Makerfabs/nRF52840-UWB-DW3000/readme.md

# Makerfabs nRF52840 UWB DW3000

**The DW3000 library in this repository was developed by NConcepts, not Makerfabs.  Makerfabs is simply responsible for maintaining the repository.**

## 1.Intruduce

Product Link ：[nRF52840 UWB DW3000](https://www.makerfabs.com/nrf52840-uwb-dw3000.html) 

Wiki Link : [nRF52840 UWB DW3000](https://wiki.makerfabs.com/nRF52840%20DW3000%20UWB.html)

Usage : [one-anchor--one-tag](https://github.com/Makerfabs/nRF52840-UWB-DW3000#31-one-anchor--one-tag)

[multi-anchor--multi-tag](https://github.com/Makerfabs/nRF52840-UWB-DW3000#32-multi-anchor--multi-tag)

## 2.Feature

- Controller: nRF52840, 64 MHz Cortex-M4 with FPU, 1 MB Flash, 256 KB RAM.
- DW3000 UWB module.

## 3. Usage

Download the DW3000 library in [GitHub](https://github.com/Makerfabs/nRF52840-UWB-DW3000/tree/main/Dw3000), and put it to the Arduino library file.

- The default is usually in the "C:\Users\Your username\Documents\Arduino\libraries"



### 3.1 One Anchor + one Tag

- Prepare the module and connect it to the PC with a USB cable.

- Open the Arduino IDE.

- Click **File-->Examples-->DW3000-->Makerfabs_Range_TX**.



- Select the development board “Nordic nRF52840 DK” and the port.

Nordic nRF52840 DK.png

- Upload the sketch to the board.

IMG20260815163745 (1).jpg

- Prepare **another module** and connect it to the PC with a USB cable.

- Click **File-->Examples-->DW3000-->Makerfabs_Range_RX**.



- Select the development board “Nordic nRF52840 DK” and the port.

- Upload the sketch to the board.



### 3.2 Multi Anchor + Multi Tag

This is the example to get the distance value from multi Tag to multi Anchor.

The network uses a designated **Master Anchor** to coordinate synchronization and network scheduling.

``` 
#define MASTER_ANCHOR_ID    0xA0
```

The Master Anchor serves as the reference node for the entire UWB network and is responsible for:

- TDMA timing coordination
- Tag scheduling reference
- Maintaining a common network time base

All Anchors and Tags in the network must be configured with the same `MASTER_ANCHOR_ID`.

**Set the board to Anchor X or Tag X**

- Open the Arduino IDE.

- Click **File-->Examples-->DW3000-->Makerfabs_Multi_Anchor_Multi_Tag_Anchor** to open the Anchor code.



- Click **File-->Examples-->DW3000-->Makerfabs_Multi_Anchor_Multi_Tag_Tag** to open the Tag code.



Modify code to get the Anchor or Tag that you want to define

``` 
// 0xA0~0xA7
#define MASTER_ANCHOR_ID    0xA0
```

``` 
//For example 0, 1, 2..
#define TAG_ID              0
```

Use Type-C USB cable to connect the board and PC, and select the development board "Nordic nRF52840 DK" and the port.

Nordic nRF52840 DK.png

Verify the code and upload.

Repeat to set up multiple Anchor and multiple Tag.

Open the port for any anchor to view the distances from all tags to all anchors.



Results for 8Tag + 8anchor


### 3.3UWB Positioning Python Program
You can use Python for UWB positioning. Double-click to open [uwb_visualizer.exe](https://github.com/Makerfabs/Makerfabs-ESP32-UWB-DW3000/tree/main/example/uwb_visualizer).



Set the coordinates for the four anchors, select the serial port for one of them, and click “Start” to begin monitoring.
