Makerfabs/nRF52840-UWB-DW3000/Hardware/UWB nRF52840 DW3000 V1.1.PDF

# P0.06P⁰.07

# SCL LEDTX

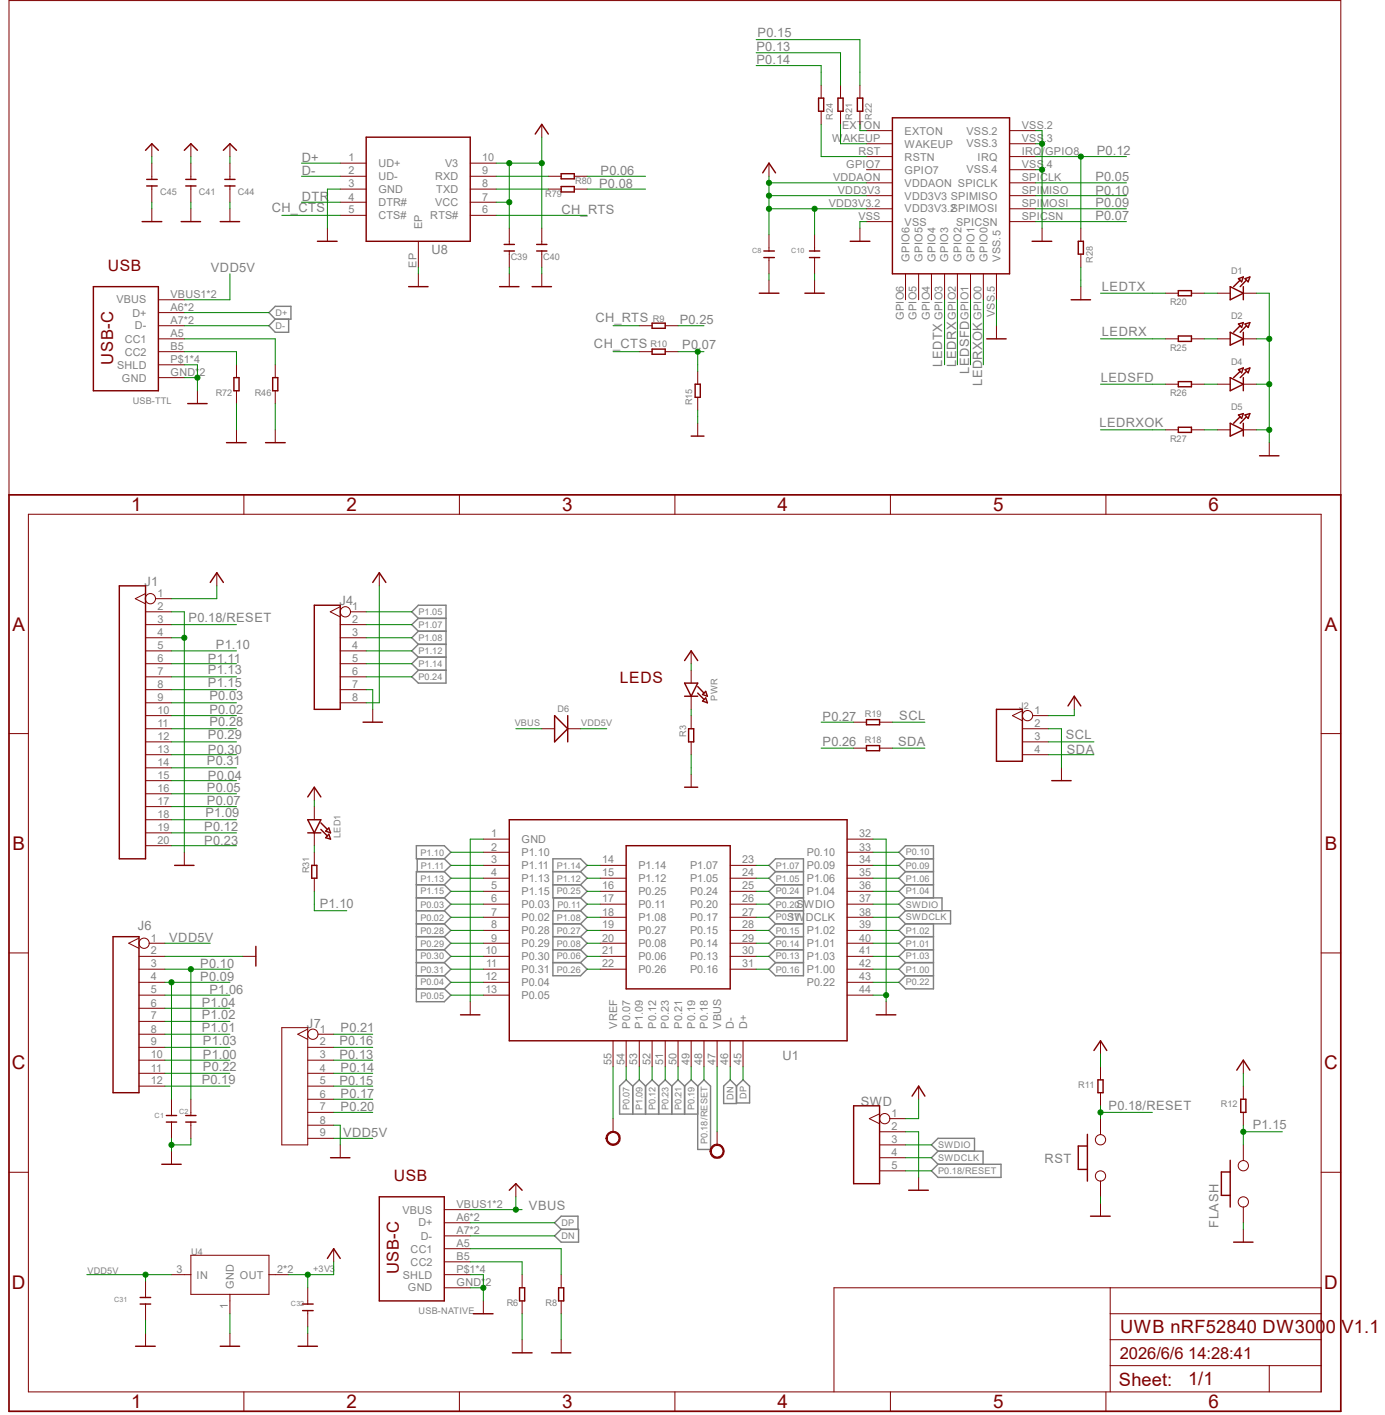
[picture p1: page 1]

6 | P1.04
8 | P1.01
9 | P1.03

4 | SWDCLK
