Makerfabs/nRF52840-UWB-DW3000/Hardware/UWB nRF52840 DW3000 V1.1.brd

## EAGLE design Hardware/UWB nRF52840 DW3000 V1.1.brd (2026-08-15)

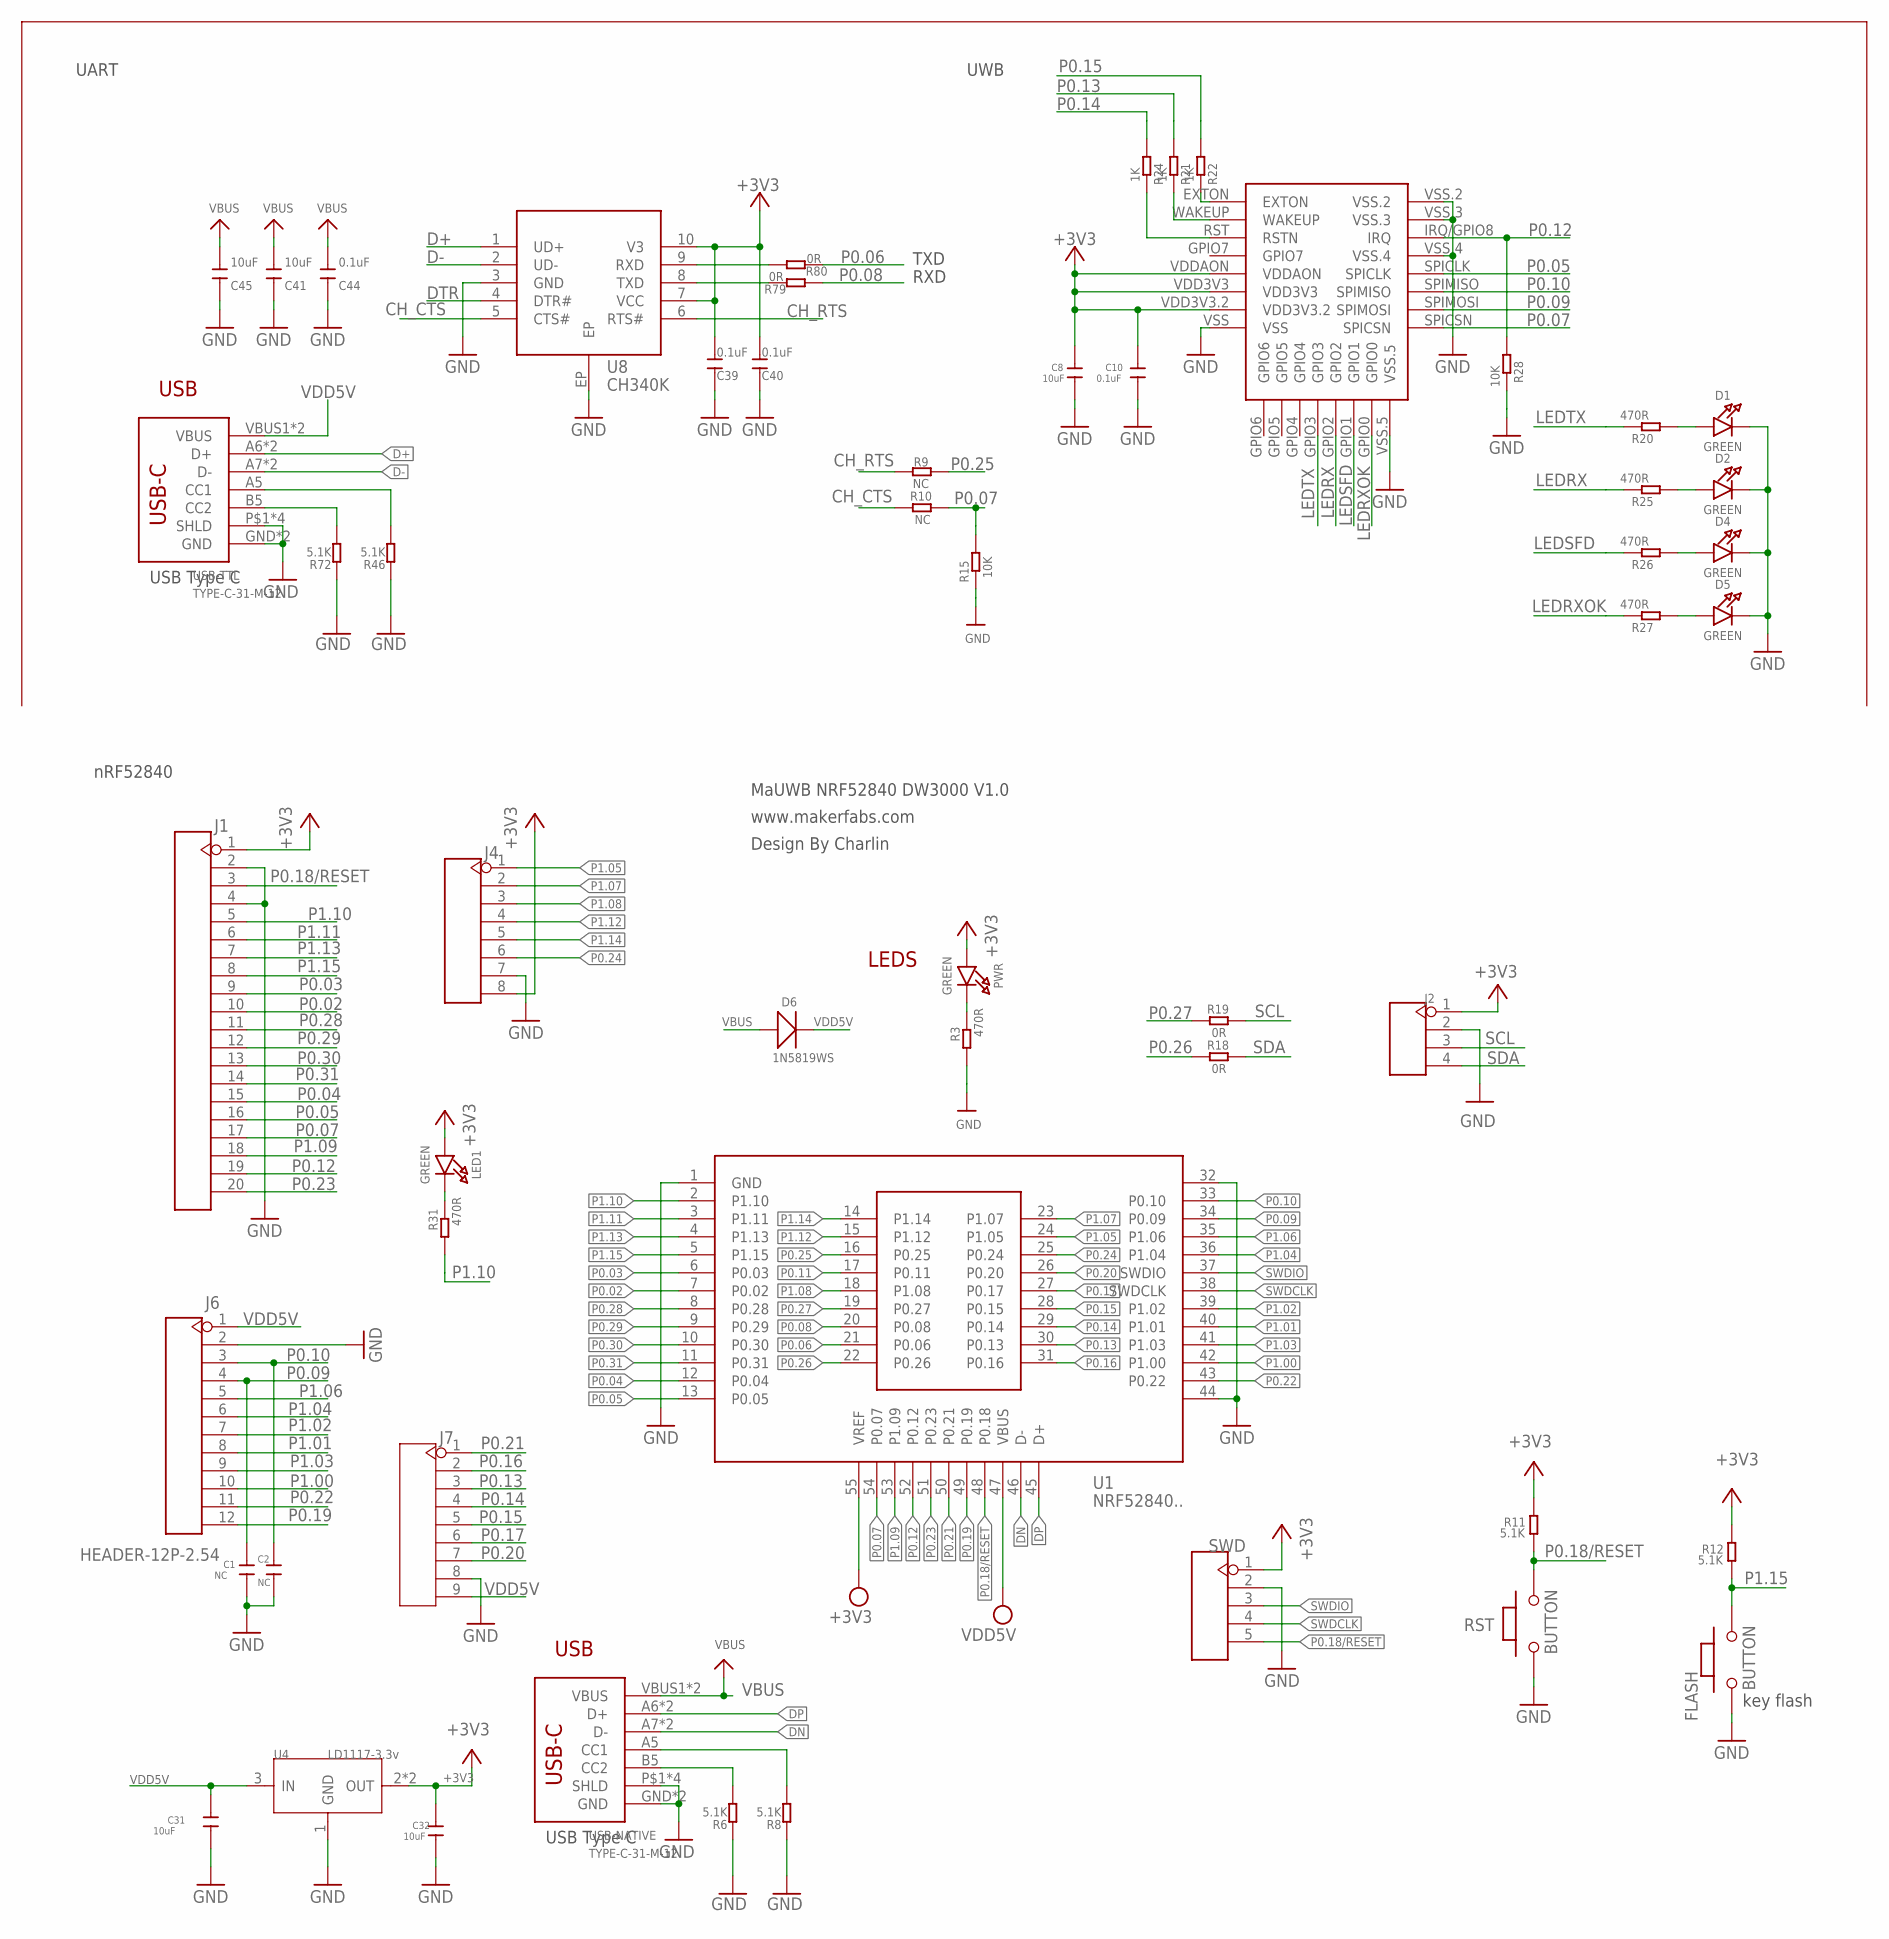
[picture p2: schematic UWB nRF52840 DW3000 V1.1.sch]

Parts:
C1, C2: NC; C0603
C8, C31, C32: 10uF; C0603
C10: 0.1uF; C0603
C39, C40, C44: 0.1uF; DISCRETE_C0603
C41, C45: 10uF; DISCRETE_C0603
D1, D2, D4, D5: GREEN; CHIPLED_0805_NOOUTLINE
D6: 1N5819WS; SOD323
FLASH: BUTTON; 157SW
J1: HEADER-20P-2.54; 20P-2.54
J2: HEADER-4P-60/35MILROUND; 4P-65/35ROUND
J4: HEADER-8P-2.54; 8P-2.54
J6: HEADER-12P-2.54; 12P-2.54
J7: HEADER-9P-2.54; 9P-2.54
LED1: GREEN; CHIPLED_0805_NOOUTLINE
PWR: GREEN; CHIPLED_0805_NOOUTLINE
R3, R20, R25, R26, R27, R31: 470R; R0603
R6, R8, R46, R72: 5.1K; DISCRETE_R0603
R9, R10: NC; R0603
R11, R12: 5.1K; R0603
R15, R28: 10K; R0603
R18, R19, R79, R80: 0R; R0603
R21, R22, R24: 1K; R0603
RST: BUTTON; 157SW
SWD: HEADER-5P-2.54; 5P-2.54
U1: NRF52840..
U4: LD1117-3.3v; SOT89
U5: DWM1000
U8: CH340K; ESOP-10-EP-150MIL
USB-NATIVE: TYPE-C-31-M-12
USB-TTL: TYPE-C-31-M-12

Connections:
+3V3: C8.1, C10.1, C32.1, C39.2, C40.2, J1.1, J2.1, J4.8, LED1.A, PWR.A, R11.2, R12.2, SWD.1, U1.55 (VREF), U4.2 (OUT), U4.4 (OUT), U5.VDD3V3, U5.VDD3V3.2, U5.VDDAON, U8.7 (VCC), U8.10 (V3)
CH_CTS: R10.2, U8.5 (CTS#)
CH_RTS: R9.2, U8.6 (RTS#)
D+: U8.1 (UD+), USB-TTL.A6 (D+), USB-TTL.B6 (D+)
D-: U8.2 (UD-), USB-TTL.A7 (D-), USB-TTL.B7 (D-)
DN: U1.46 (D-), USB-NATIVE.A7 (D-), USB-NATIVE.B7 (D-)
DP: U1.45 (D+), USB-NATIVE.A6 (D+), USB-NATIVE.B6 (D+)
DTR: U8.4 (DTR#)
GND: C1.2, C2.2, C8.2, C10.2, C31.2, C32.2, C39.1, C40.1, C41.1, C44.1, C45.1, D1.C, D2.C, D4.C, D5.C, FLASH.1, J1.2, J1.4, J2.2, J4.7, J6.2, J7.8, R3.2, R6.1, R8.1, R15.2, R28.1, R46.1, R72.1, RST.1, SWD.2, U1.1 (GND), U1.32, U1.44, U4.1 (GND), U5.VSS, U5.VSS.2, U5.VSS.3, U5.VSS.4, U5.VSS.5, U8.3 (GND), U8.EP, USB-NATIVE.GND, USB-NATIVE.GND2 (GND), USB-NATIVE.P$1 (SHLD), USB-NATIVE.P$2 (SHLD), USB-NATIVE.P$3 (SHLD), USB-NATIVE.P$4 (SHLD), USB-TTL.GND, USB-TTL.GND2 (GND), USB-TTL.P$1 (SHLD), USB-TTL.P$2 (SHLD), USB-TTL.P$3 (SHLD), USB-TTL.P$4 (SHLD)
LEDRX: R25.1, U5.GPIO2
LEDRXOK: R27.1, U5.GPIO0
LEDSFD: R26.1, U5.GPIO1
LEDTX: R20.1, U5.GPIO3
unnamed: LED1.C, R31.1
unnamed: D1.A, R20.2
unnamed: D2.A, R25.2
unnamed: PWR.C, R3.1
unnamed: D4.A, R26.2
unnamed: D5.A, R27.2
unnamed: R22.1, U5.EXTON
unnamed: R21.1, U5.WAKEUP
unnamed: R24.1, U5.RST (RSTN)
unnamed: R46.2, USB-TTL.A5 (CC1)
unnamed: R72.2, USB-TTL.B5 (CC2)
unnamed: R8.2, USB-NATIVE.A5 (CC1)
unnamed: R6.2, USB-NATIVE.B5 (CC2)
unnamed: R80.2, U8.9 (RXD)
unnamed: R79.2, U8.8 (TXD)
P0.02: J1.10, U1.7 (P0.02)
P0.03: J1.9, U1.6 (P0.03)
P0.04: J1.15, U1.12 (P0.04)
P0.05: J1.16, U1.13 (P0.05), U5.SPICLK
P0.06: R80.1, U1.21 (P0.06)
P0.07: J1.17, R10.1, R15.1, U1.54 (P0.07), U5.SPICSN
P0.08: R79.1, U1.20 (P0.08)
P0.09: C1.1, J6.4, U1.34 (P0.09), U5.SPIMOSI
P0.10: C2.1, J6.3, U1.33 (P0.10), U5.SPIMISO
P0.11: U1.17 (P0.11)
P0.12: J1.19, R28.2, U1.52 (P0.12), U5.IRQ/GPIO8 (IRQ)
P0.13: J7.3, R21.2, U1.30 (P0.13)
P0.14: J7.4, R24.2, U1.29 (P0.14)
P0.15: J7.5, R22.2, U1.28 (P0.15)
P0.16: J7.2, U1.31 (P0.16)
P0.17: J7.6, U1.27 (P0.17)
P0.18/RESET: J1.3, R11.1, RST.2, SWD.5, U1.48 (P0.18)
P0.19: J6.12, U1.49 (P0.19)
P0.20: J7.7, U1.26 (P0.20)
P0.21: J7.1, U1.50 (P0.21)
P0.22: J6.11, U1.43 (P0.22)
P0.23: J1.20, U1.51 (P0.23)
P0.24: J4.6, U1.25 (P0.24)
P0.25: R9.1, U1.16 (P0.25)
P0.26: R18.2, U1.22 (P0.26)
P0.27: R19.2, U1.19 (P0.27)
P0.28: J1.11, U1.8 (P0.28)
P0.29: J1.12, U1.9 (P0.29)
P0.30: J1.13, U1.10 (P0.30)
P0.31: J1.14, U1.11 (P0.31)
P1.00: J6.10, U1.42 (P1.00)
P1.01: J6.8, U1.40 (P1.01)
P1.02: J6.7, U1.39 (P1.02)
P1.03: J6.9, U1.41 (P1.03)
P1.04: J6.6, U1.36 (P1.04)
P1.05: J4.1, U1.24 (P1.05)
P1.06: J6.5, U1.35 (P1.06)
P1.07: J4.2, U1.23 (P1.07)
P1.08: J4.3, U1.18 (P1.08)
P1.09: J1.18, U1.53 (P1.09)
P1.10: J1.5, R31.2, U1.2 (P1.10)
P1.11: J1.6, U1.3 (P1.11)
P1.12: J4.4, U1.15 (P1.12)
P1.13: J1.7, U1.4 (P1.13)
P1.14: J4.5, U1.14 (P1.14)
P1.15: FLASH.2, J1.8, R12.1, U1.5 (P1.15)
SCL: J2.3, R19.1
SDA: J2.4, R18.1
SWDCLK: SWD.4, U1.38 (SWDCLK)
SWDIO: SWD.3, U1.37 (SWDIO)
VBUS: C41.2, C44.2, C45.2, D6.+, USB-NATIVE.VBUS1 (VBUS), USB-NATIVE.VBUS2 (VBUS)
VDD5V: C31.1, D6.-, J6.1, J7.9, U1.47 (VBUS), U4.3 (IN), USB-TTL.VBUS1 (VBUS), USB-TTL.VBUS2 (VBUS)

Notes on the sheet:
LEDS
key flash
MaUWB NRF52840 DW3000 V1.0
www.makerfabs.com
Design By Charlin
USB
USB Type C
RXD
TXD
UART
UWB
nRF52840

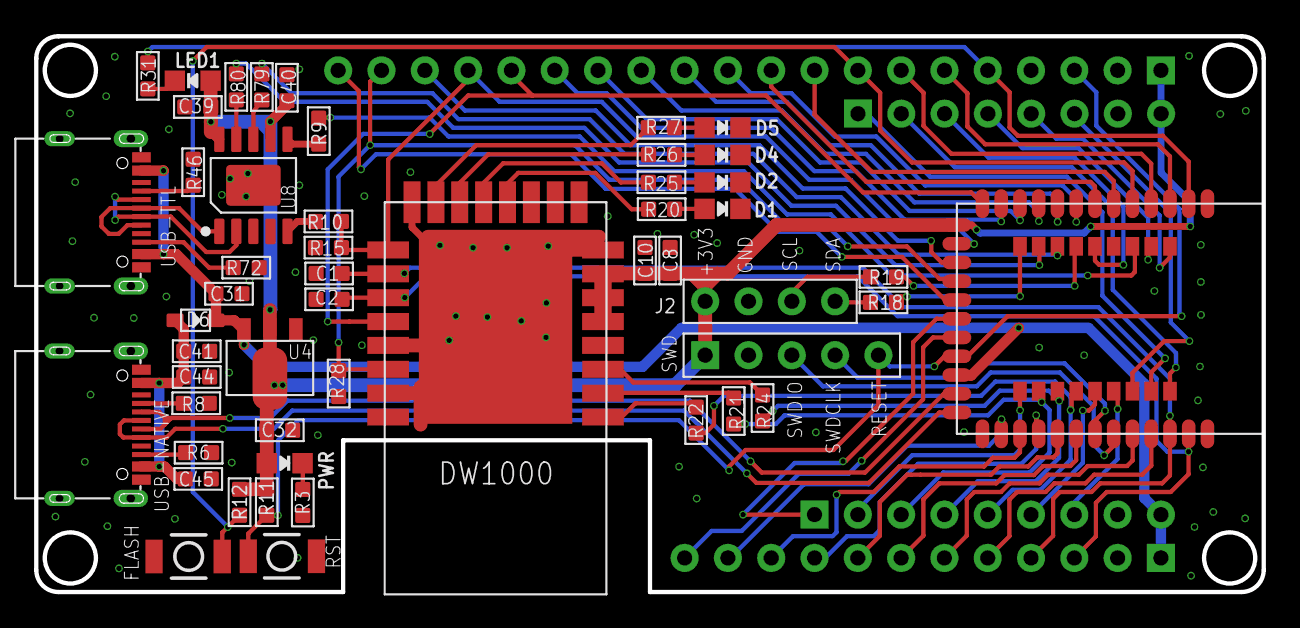
[picture p3: board UWB nRF52840 DW3000 V1.1.brd from above]

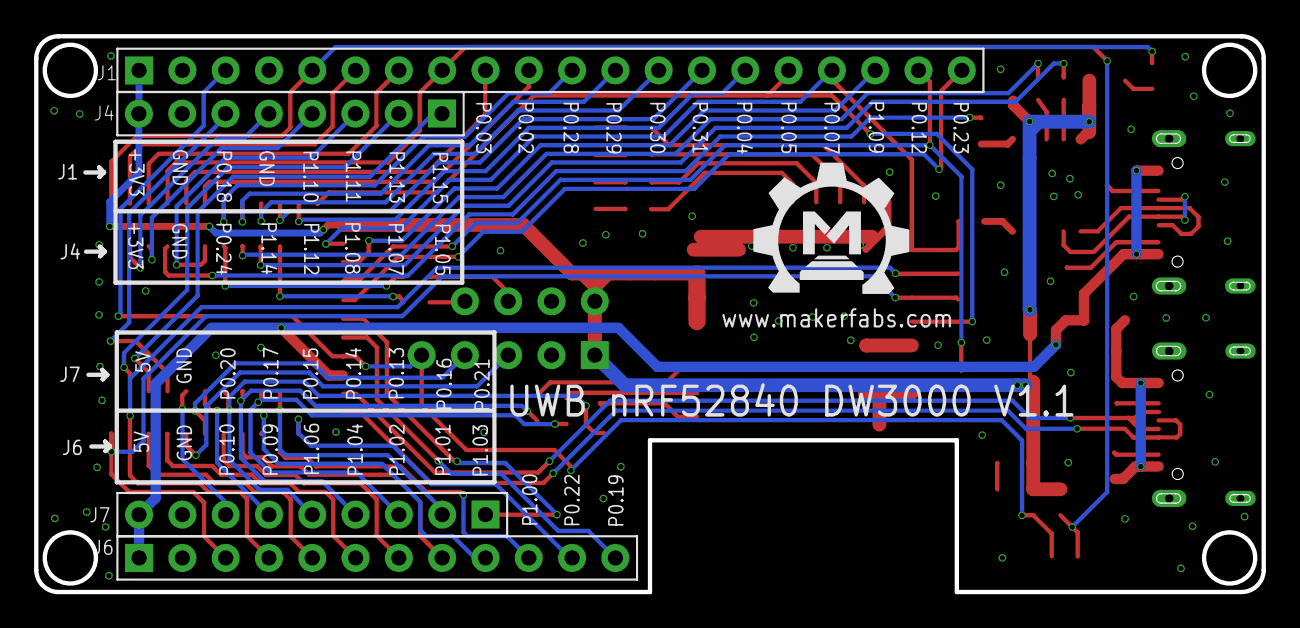
[picture p4: board UWB nRF52840 DW3000 V1.1.brd from below]

Board: 2 copper layers, 72.0 x 32.6 mm, 56 parts (5 on the bottom side), 78 nets.

Other parts of the board:
U$1: MAKERFABS_0.3
